AmeerHamzaDiode/ESP32_BME280_BH1750FVI_SGP30_Board_v1-Files/ESP32_BME280_BH1750FVI_SGP30_Board_v1_1.jpg

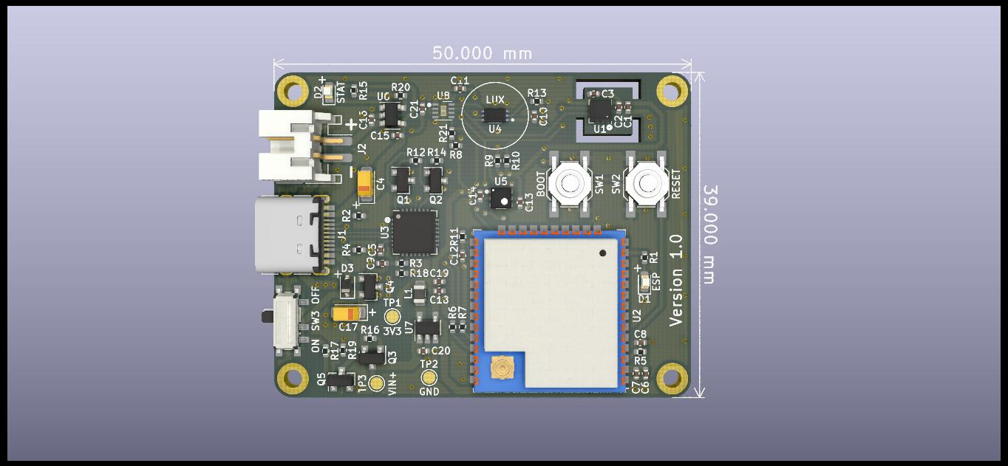
ESP32_BME280_BH1750FVI_SGP30_Board_v1_1.jpg
