AmeerHamzaDiode/ESP32_BME280_BH1750FVI_SGP30_Board_v1-Files/Bill of Materials-BOM.xlsx

Designator | Comment | Quantity | Footprint | Manufacturer Name | Manufacturer Part # | JLCPCB Part #
C18,C16,C15,C6,C1 | 10uF | 5 | C_0402_1005Metric | Samsung Electro-Mechanics | CL05A106MQ5NUNC | C15525
C21,C19,C14,C10,C9,C7,C5,C3,C2 | 0.1uF | 9 | C_0402_1005Metric | Samsung Electro-Mechanics | CL05B104KO5NNNC | C1525
C17,C4 | 10uF | 2 | CP_EIA-3216-18_Kemet-A | KYOCERA AVX | TAJA106K016RNJ | C7171
C13,C12,C11,C8 | 1uF | 4 | C_0402_1005Metric | Samsung Electro-Mechanics | CL05A105KA5NQNC | C52923
C20 | 4.7uF | 1 | C_0402_1005Metric | Samsung Electro-Mechanics | CL05A475MP5NRNC | C23733
D1 | ESP | 1 | LED_0603_1608Metric | Hubei KENTO Elec | KT-0603W | C2290
D2 | STAT | 1 | LED_0603_1608Metric | Hubei KENTO Elec | KT-0603R | C2286
D3 | 1N5819WS | 1 | D_SOD-323 | Guangdong Hottech | 1N5819WS | C191023
J1 | TYPE-C-31-M-12 | 1 | USB_C_Receptacle_HRO_TYPE-C-31-M-12 | Korean Hroparts Elec | TYPE-C-31-M-12 | C165948
J2 | S2B-PH | 1 | JST_PH_S2B-PH-SM4-TB_1x02-1MP_P2.00mm_Horizontal | JST | S2B-PH-SM4-TB(LF)(SN) | C295747
L1 | 2.2uH | 1 | L_0805_2012Metric | FH (Guangdong Fenghua Advanced Tech) | CMH201209B2R2MTD | C394957
Q2,Q1 | SS8050 | 2 | SOT-23 | Jiangsu Changjing Electronics Technology Co., Ltd. | SS8050(RANGE:200-350) | C2150
Q4,Q3 | SI2301CDS-T1-GE3 | 2 | SOT-23 | Vishay Intertech | SI2301CDS-T1-GE3 | C10487
Q5 | 2N7002 | 1 | SOT-23 | Jiangsu Changjing Electronics Technology Co., Ltd. | 2N7002 | C8545
R17,R1 | 470R | 2 | R_0402_1005Metric | UNI-ROYAL(Uniroyal Elec) | 0402WGF4700TCE | C25117
R4,R2 | 5.1K | 2 | R_0402_1005Metric | UNI-ROYAL(Uniroyal Elec) | 0402WGF5101TCE | C25905
R21,R19,R16,R14,R12,R11,R10,R9,R5,R3 | 10K | 10 | R_0402_1005Metric | UNI-ROYAL(Uniroyal Elec) | 0402WGF1002TCE | C25744
R15,R13,R8,R7,R6 | 1K | 5 | R_0402_1005Metric | UNI-ROYAL(Uniroyal Elec) | 0402WGF1001TCE | C11702
R18 | 100K | 1 | R_0402_1005Metric | UNI-ROYAL(Uniroyal Elec) | 0402WGF1003TCE | C25741
R20 | 2K | 1 | R_0402_1005Metric | UNI-ROYAL(Uniroyal Elec) | 0402WGF2001TCE | C4109
SW1 | BOOT | 1 | SW_SPST_SKQG_WithoutStem | XKB Connection | TS-1187A-B-A-B | C318884
SW2 | RESET | 1 | SW_SPST_SKQG_WithoutStem | XKB Connection | TS-1187A-B-A-B | C318884
SW3 | K3-1296S-E1 | 1 | Slide_switch_K3-1296S-E1 | Korean Hroparts Elec | K3-1296S-E1 | C128955
U1 | BME280 | 1 | Bosch_LGA-8_2.5x2.5mm_P0.65mm_ClockwisePinNumbering | Bosch Sensortec | BME280 | C92489
U2 | ESP32-WROOM-32UE-N8 | 1 | ESP32-WROOM-32U | Espressif Systems | ESP32-WROOM-32UE-N8 | C701345
U3 | CP2102-GMR | 1 | QFN-28-1EP_5x5mm_P0.5mm_EP3.35x3.35mm | SKYWORKS/SILICON LABS | CP2102-GMR | C6568
U4 | BH1750FVI-TR | 1 | BH1750FVI-TR | ROHM Semicon | BH1750FVI-TR | C78960
U5 | SGP30-2.5K | 1 | SGP40-D-R4 | Sensirion | SGP30-2.5k | C514454
U6 | MCP73831T-2ACI/OT | 1 | SOT-23-5 | Microchip Tech | MCP73831T-2ACI/OT | C424093
U7 | LM3671MFX-3.3/NOPB | 1 | TSOT-23-5 | Texas Instruments | LM3671MFX-3.3/NOPB | C477918
U8 | MAX17048G+T10 | 1 | DFN-8-1EP_2x2mm_P0.5mm_EP0.6x1.2mm | Analog Devices Inc./Maxim Integrated | MAX17048G+T10 | C2682616
