AmeerHamzaDiode/ESP32_BME280_BH1750FVI_SGP30_Board_v1-Files/ESP32_BME280_BH1750FVI_SGP30_Board_v1.kicad_pcb

## KiCad design ESP32_BME280_BH1750FVI_SGP30_Board_v1.kicad_pcb (2025-04-10)

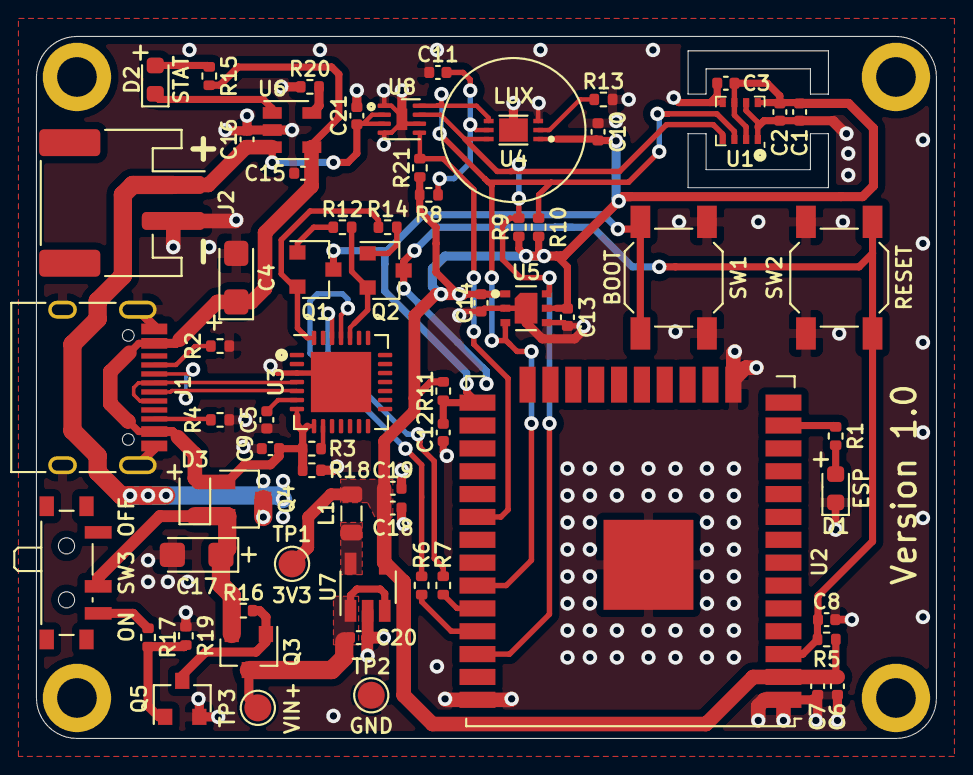
[picture p3: board ESP32_BME280_BH1750FVI_SGP30_Board_v1.kicad_pcb from above]

Board: 2 copper layers, 50.0 x 39.0 mm, 71 parts (0 on the bottom side), 36 nets.

Parts:
C1, C6, C15, C16, C18: 10uF; C_0402_1005Metric
C2, C3, C5, C7, C9, C10, C14, C19, C21: 0.1uF; C_0402_1005Metric
C4, C17: 10uF; CP_EIA-3216-18_Kemet-A
C8, C11, C12, C13: 1uF; C_0402_1005Metric
C20: 4.7uF; C_0402_1005Metric
D1: ESP; LED_0603_1608Metric
D2: STAT; LED_0603_1608Metric
D3: 1N5819WS; D_SOD-323
H1, H2, H3, H4: M2; MountingHole_2.2mm_M2_DIN965_Pad
J1: TYPE-C-31-M-12; USB_C_Receptacle_HRO_TYPE-C-31-M-12
J2: S2B-PH; JST_PH_S2B-PH-SM4-TB_1x02-1MP_P2.00mm_Horizontal
L1: 2.2uH; L_0805_2012Metric
Q1, Q2: SS8050; SOT-23
Q3, Q4: SI2301CDS-T1-GE3; SOT-23
Q5: 2N7002; SOT-23
R1, R17: 470R; R_0402_1005Metric
R2, R4: 5.1K; R_0402_1005Metric
R3, R5, R9, R10, R11, R12, R14, R16, R19, R21: 10K; R_0402_1005Metric
R6, R7, R8, R13, R15: 1K; R_0402_1005Metric
R18: 100K; R_0402_1005Metric
R20: 2K; R_0402_1005Metric
SW1: BOOT; SW_SPST_SKQG_WithoutStem
SW2: RESET; SW_SPST_SKQG_WithoutStem
SW3: K3-1296S-E1; Slide_switch_K3-1296S-E1
TP1: 3V3; TestPoint_Pad_D1.5mm
TP2: GND; TestPoint_Pad_D1.5mm
TP3: VIN+; TestPoint_Pad_D1.5mm
U1: BME280; Bosch_LGA-8_2.5x2.5mm_P0.65mm_ClockwisePinNumbering
U2: ESP32-WROOM-32UE-N8; ESP32-WROOM-32U
U3: CP2102-GMR; QFN-28-1EP_5x5mm_P0.5mm_EP3.35x3.35mm
U4: BH1750FVI-TR
U5: SGP30-2.5K; SGP40-D-R4
U6: MCP73831T-2ACI/OT; SOT-23-5
U7: LM3671MFX-3.3/NOPB; TSOT-23-5
U8: MAX17048G+T10; DFN-8-1EP_2x2mm_P0.5mm_EP0.6x1.2mm

Connections:
+3V3: C1.1, C2.1, C3.1, C6.1, C7.1, C10.1, C13.1, C14.1, C18.1, C19.1, L1.2, R5.2, R8.1, R9.1, R10.1, R11.2, R21.1, TP1.1, U1.2, U1.6, U1.8, U2.2, U4.1, U5.1, U5.5, U7.4
+BATT: C16.1, C21.1, J2.1, Q4.3, U6.3, U8.2, U8.3
/PWR+: C17.1, D3.1, Q3.2, Q4.2, R16.1, SW3.2
/VIN+: C20.1, Q3.3, TP3.1, U7.1, U7.3
BOOT: C12.1, Q1.3, R11.1, SW1.2, U2.25
D+: J1.A6, J1.B6, U3.4
D-: J1.A7, J1.B7, U3.5
DTR: Q1.2, R14.1, U3.28
GND: C1.2, C2.2, C3.2, C4.2, C5.2, C6.2, C7.2, C8.2, C9.2, C10.2, C11.2, C12.2, C13.2, C14.2, C15.2, C16.2, C17.2, C18.2, C19.2, C20.2, C21.2, D1.1, J1.A1, J1.A12, J1.B1, J1.B12, J1.S1, J2.2, Q5.2, R2.1, R4.1, R13.2, R18.2, R19.2, R20.2, SW1.1, SW2.1, TP2.1, U1.1, U1.5, U1.7, U2.1, U2.15, U2.38, U2.39, U3.3, U3.29, U4.3, U4.7, U5.2, U5.4, U5.7, U6.2, U7.2, U8.1, U8.4, U8.6, U8.9
IO14: R1.1, U2.13
IO18: R21.2, U2.30, U8.5
unnamed: C5.1, U3.6
unnamed: C11.1, R8.2, U4.5
unnamed: D1.2, R1.2
unnamed: D2.1, U6.1
unnamed: D2.2, R15.2
unnamed: J1.A5, R2.2
unnamed: J1.B5, R4.2
unnamed: L1.1, U7.5
unnamed: Q1.1, R12.2
unnamed: Q2.1, R14.2
unnamed: Q3.1, Q5.3, R16.2
unnamed: Q5.1, R17.1, R19.1
unnamed: R3.2, U3.9
unnamed: R6.1, U2.35
unnamed: R7.2, U2.34
unnamed: R13.1, U4.2
unnamed: R17.2, SW3.3
unnamed: R20.1, U6.5
RESET: C8.1, Q2.3, R5.1, SW2.2, U2.3
RTS: Q2.2, R12.1, U3.24
RXD: R6.2, U3.25
SCL: R9.2, U1.4, U2.36, U4.6, U5.6, U8.7
SDA: R10.2, U1.3, U2.33, U4.4, U5.3, U8.8
TXD: R7.1, U3.26
VBUS: C4.1, C9.1, C15.1, D3.2, J1.A4, J1.A9, J1.B4, J1.B9, Q4.1, R3.1, R15.1, R18.1, U3.7, U3.8, U6.4
